pablosilvarojas93/automated-falling-ball-viscometer/Gravitational viscometer P2.stl

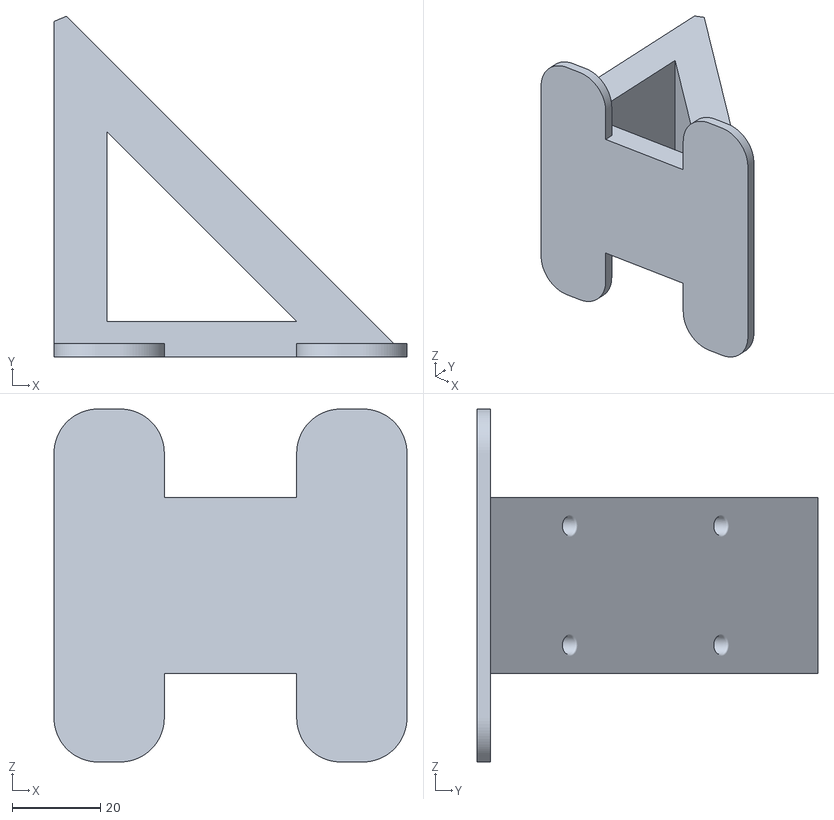
[picture p1: CAD file, 2023-08-08]
Gravitational viscometer P2.stl
80.0 x 77.2 x 80.0
