pablosilvarojas93/automated-falling-ball-viscometer/Gravitational viscometer P1.stl

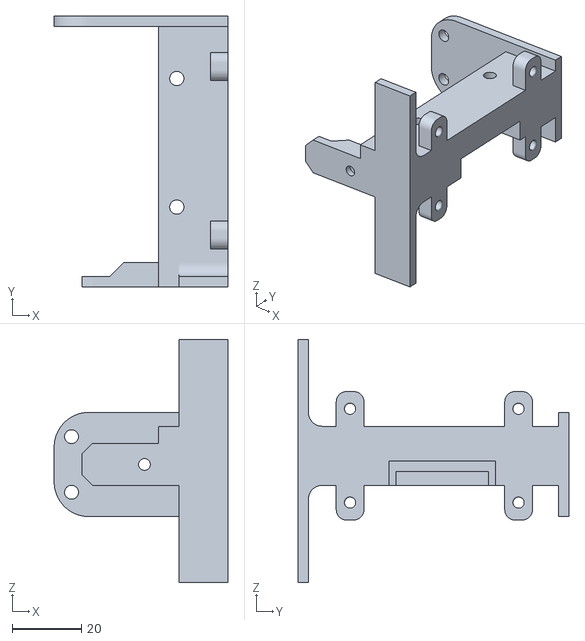
[picture p2: CAD file, 2023-08-08]
Gravitational viscometer P1.stl
50.0 x 78.0 x 70.0
