pablosilvarojas93/automated-falling-ball-viscometer/(list of files, cad)

Other CAD files:
Gravitational viscometer P1.ipt
Gravitational viscometer P2.ipt
