pablosilvarojas93/automated-falling-ball-viscometer/Schematic_Falling ball viscosimeter_2023-08-08.pdf

# Minimal configuration of a automated falling ball viscosimeter

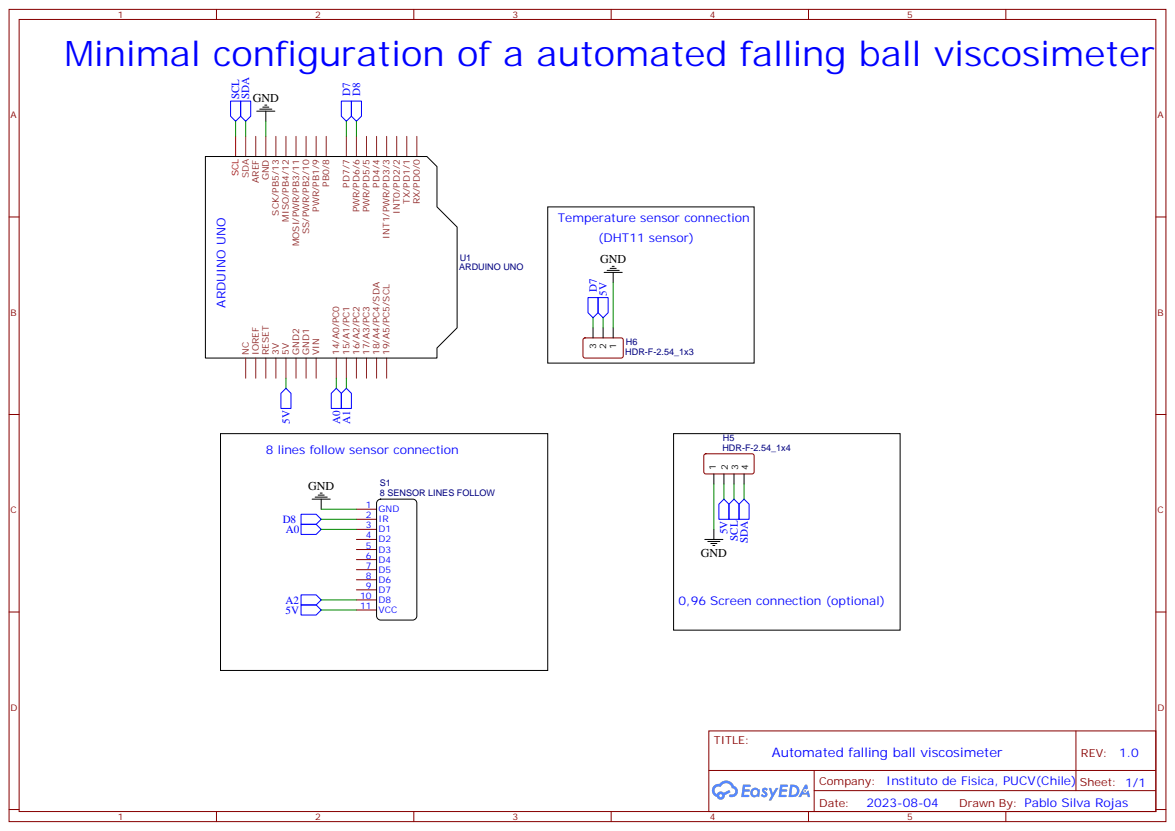
[picture p3: page 1]

8 lines follow sensor connection

Company: Instituto de Fisica, PUCV(Chile)

Drawn By: Pablo Silva Rojas
