pablosilvarojas93/automated-falling-ball-viscometer/(commit log)

2023-08-04 Create Automated falling ball calibration method
2023-08-05 Update Automated falling ball calibration method
2023-08-12 Automated falling ball calibration method
